BroderickCarlin/cgb-reg/README.md

# cgb-reg
CGB-REG chip replacement for Gameboy Color LCD drive circuitry
