BroderickCarlin/cgb-reg/cgb-reg/CGB-REG.kicad_pcb

## KiCad design cgb-reg/CGB-REG.kicad_pcb (2023-11-17)

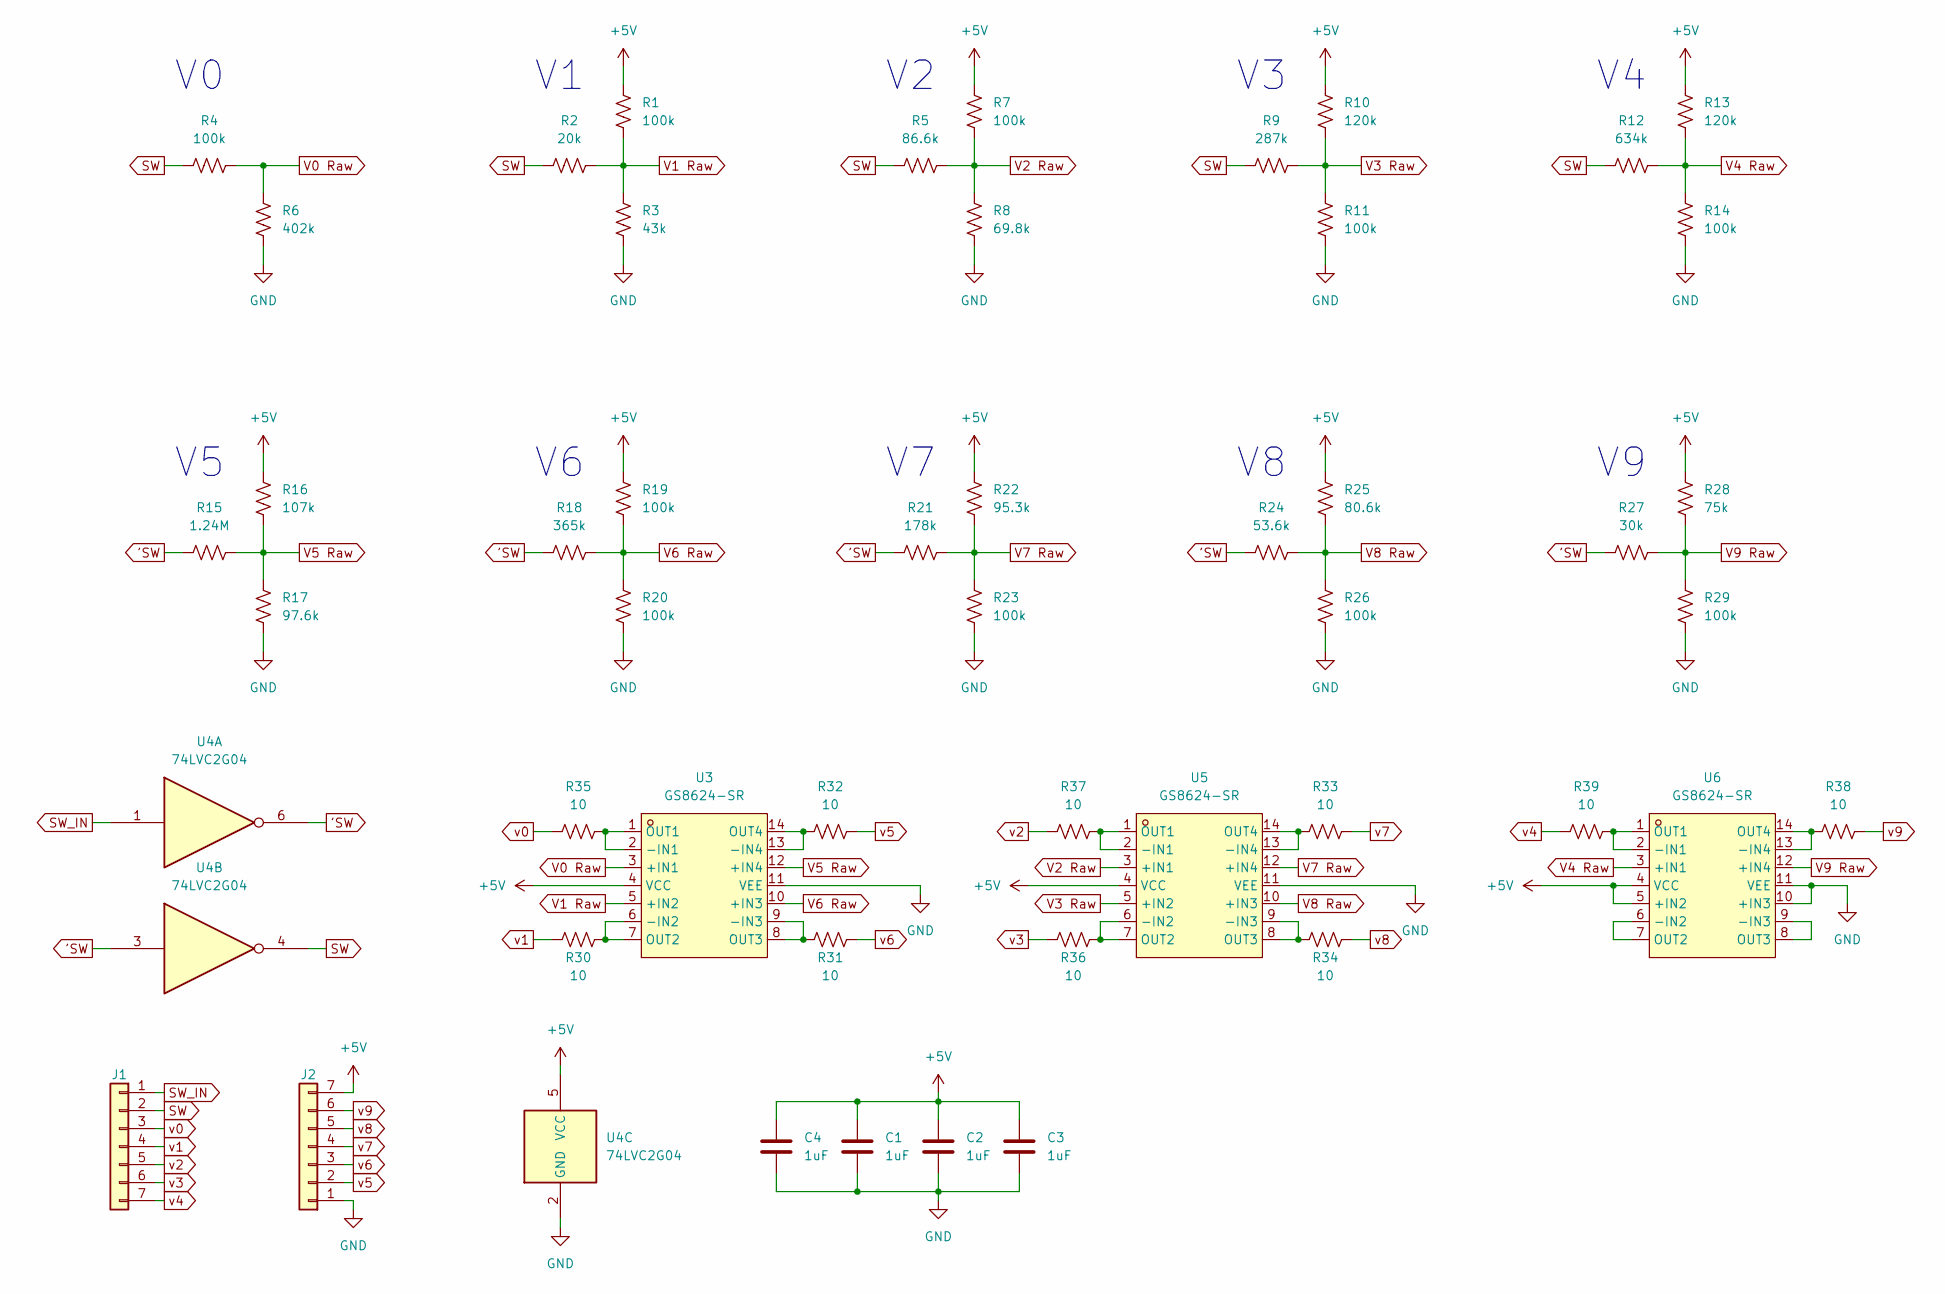
[picture p1: schematic CGB-REG.kicad_sch, CGB-REG Replacement Circuit]

Parts:
C1, C2, C3, C4: 1uF; C_0603_1608Metric; LCSC C89376
J1, J2: Conn_01x07; PinHeader_1x07_P2.54mm_Vertical
R1, R4, R7, R11, R14, R19, R20, R23, R26, R29: 100k; R_0603_1608Metric; LCSC C414506
R2: 20k; R_0603_1608Metric; LCSC C844340
R3: 43k; R_0603_1608Metric; LCSC C340523
R5: 86.6k; R_0603_1608Metric; LCSC C403381
R6: 402k; R_0603_1608Metric; LCSC C23048
R8: 69.8k; R_0603_1608Metric; LCSC C170663
R9: 287k; R_0603_1608Metric; LCSC C13174
R10, R13: 120k; R_0603_1608Metric; LCSC C325641
R12: 634k; R_0603_1608Metric; LCSC C321970
R15: 1.24M; R_0603_1608Metric; LCSC C367719
R16: 107k; R_0603_1608Metric; LCSC C103221
R17: 97.6k; R_0603_1608Metric; LCSC C507495
R18: 365k; R_0603_1608Metric; LCSC C367800
R21: 178k; R_0603_1608Metric; LCSC C103349
R22: 95.3k; R_0603_1608Metric; LCSC C912224
R24: 53.6k; R_0603_1608Metric; LCSC C103706
R25: 80.6k; R_0603_1608Metric; LCSC C2933260
R27: 30k; R_0603_1608Metric; LCSC C667692
R28: 75k; R_0603_1608Metric; LCSC C881187
R30, R31, R32, R33, R34, R35, R36, R37, R38, R39: 10; R_0603_1608Metric; LCSC C2791798
U3, U5, U6: GS8624-SR; SOIC-14_L8.6-W3.9-P1.27-LS6.0-BL; LCSC Part C605417
U4: 74LVC2G04; SOT-363_SC-70-6; LCSC C460538

Connections:
'SW: R15.2, R18.2, R21.2, R24.2, R27.2, U4.3, U4.6
+5V: C1.1, C2.1, C3.1, C4.1, J2.7, R1.1, R7.1, R10.1, R13.1, R16.1, R19.1, R22.1, R25.1, R28.1, U3.4 (VCC), U4.5 (VCC), U5.4 (VCC), U6.4 (VCC), U6.5 (+IN2)
GND: C1.2, C2.2, C3.2, C4.2, J2.1, R3.2, R6.2, R8.2, R11.2, R14.2, R17.2, R20.2, R23.2, R26.2, R29.2, U3.11 (VEE), U4.2 (GND), U5.11 (VEE), U6.10 (+IN3), U6.11 (VEE)
unnamed: R35.2, U3.1 (OUT1), U3.2 (-IN1)
unnamed: R30.2, U3.6 (-IN2), U3.7 (OUT2)
unnamed: R31.1, U3.8 (OUT3), U3.9 (-IN3)
unnamed: R32.1, U3.13 (-IN4), U3.14 (OUT4)
unnamed: R37.2, U5.1 (OUT1), U5.2 (-IN1)
unnamed: R36.2, U5.6 (-IN2), U5.7 (OUT2)
unnamed: R34.1, U5.8 (OUT3), U5.9 (-IN3)
unnamed: R33.1, U5.13 (-IN4), U5.14 (OUT4)
unnamed: R39.2, U6.1 (OUT1), U6.2 (-IN1)
unnamed: U6.6 (-IN2), U6.7 (OUT2)
unnamed: U6.8 (OUT3), U6.9 (-IN3)
unnamed: R38.2, U6.13 (-IN4), U6.14 (OUT4)
SW: J1.2, R2.2, R4.2, R5.2, R9.2, R12.2, U4.4
SW_IN: J1.1, U4.1
V0 Raw: R4.1, R6.1, U3.3 (+IN1)
V1 Raw: R1.2, R2.1, R3.1, U3.5 (+IN2)
V2 Raw: R5.1, R7.2, R8.1, U5.3 (+IN1)
V3 Raw: R9.1, R10.2, R11.1, U5.5 (+IN2)
V4 Raw: R12.1, R13.2, R14.1, U6.3 (+IN1)
V5 Raw: R15.1, R16.2, R17.1, U3.12 (+IN4)
V6 Raw: R18.1, R19.2, R20.1, U3.10 (+IN3)
V7 Raw: R21.1, R22.2, R23.1, U5.12 (+IN4)
V8 Raw: R24.1, R25.2, R26.1, U5.10 (+IN3)
V9 Raw: R27.1, R28.2, R29.1, U6.12 (+IN4)
v0: J1.3, R35.1
v1: J1.4, R30.1
v2: J1.5, R37.1
v3: J1.6, R36.1
v4: J1.7, R39.1
v5: J2.2, R32.2
v6: J2.3, R31.2
v7: J2.4, R33.2
v8: J2.5, R34.2
v9: J2.6, R38.1

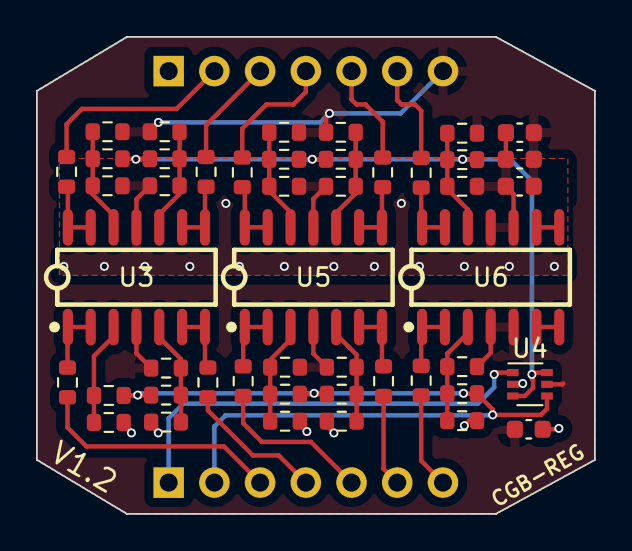
[picture p2: board CGB-REG.kicad_pcb from above]

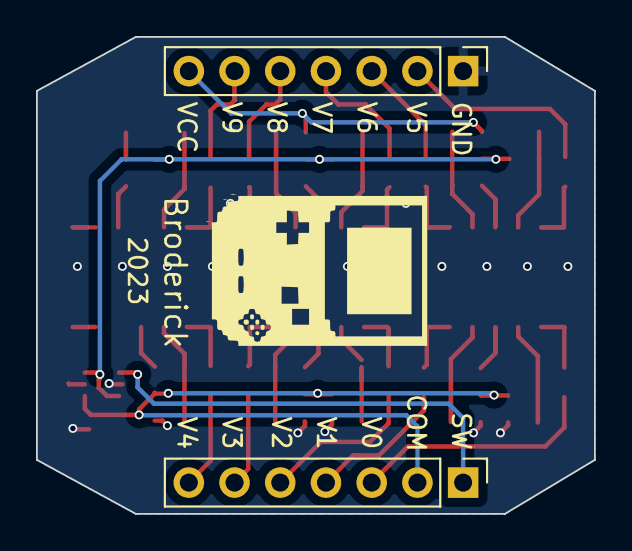
[picture p3: board CGB-REG.kicad_pcb from below]

Board: 2 copper layers, 31.0 x 26.5 mm, 49 parts (2 on the bottom side), 37 nets.
