BroderickCarlin/cgb-reg/cgb-reg-breakout/cgb-reg-breakout.kicad_pcb

## KiCad design cgb-reg-breakout/cgb-reg-breakout.kicad_pcb (2023-11-14)

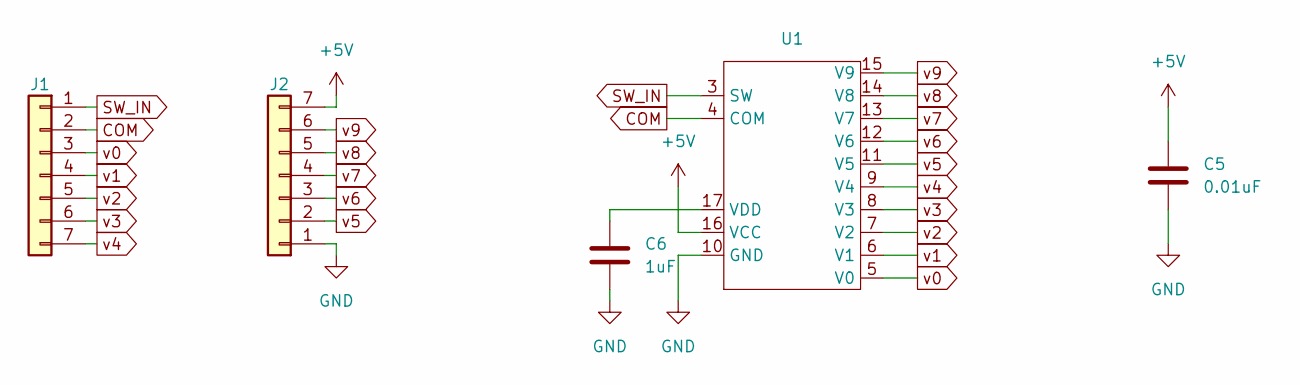
[picture p4: schematic cgb-reg-breakout.kicad_sch, CGB-REG Replacement Circuit]

Parts:
C5: 0.01uF; C_0603_1608Metric
C6: 1uF; C_0603_1608Metric; LCSC C89376
J1, J2: Conn_01x07; PinHeader_1x07_P2.54mm_Vertical
U1: CGB-REG

Connections:
+5V: C5.1, J2.7, U1.16 (VCC)
COM: J1.2, U1.4 (COM)
GND: C5.2, C6.2, J2.1, U1.10 (GND)
unnamed: C6.1, U1.17 (VDD)
SW_IN: J1.1, U1.3 (SW)
v0: J1.3, U1.5 (V0)
v1: J1.4, U1.6 (V1)
v2: J1.5, U1.7 (V2)
v3: J1.6, U1.8 (V3)
v4: J1.7, U1.9 (V4)
v5: J2.2, U1.11 (V5)
v6: J2.3, U1.12 (V6)
v7: J2.4, U1.13 (V7)
v8: J2.5, U1.14 (V8)
v9: J2.6, U1.15 (V9)

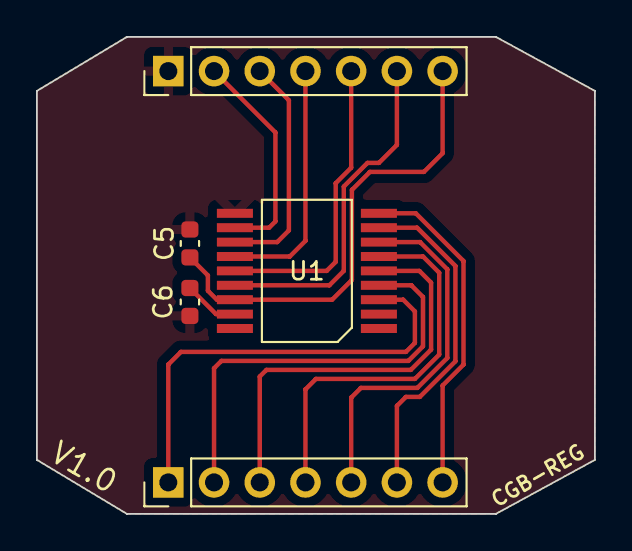
[picture p5: board cgb-reg-breakout.kicad_pcb from above]

Board: 2 copper layers, 31.0 x 26.5 mm, 5 parts (0 on the bottom side), 15 nets.
