BroderickCarlin/cgb-reg/pwr-dist/pwr-dist.kicad_pcb

## KiCad design pwr-dist/pwr-dist.kicad_pcb (2023-11-14)

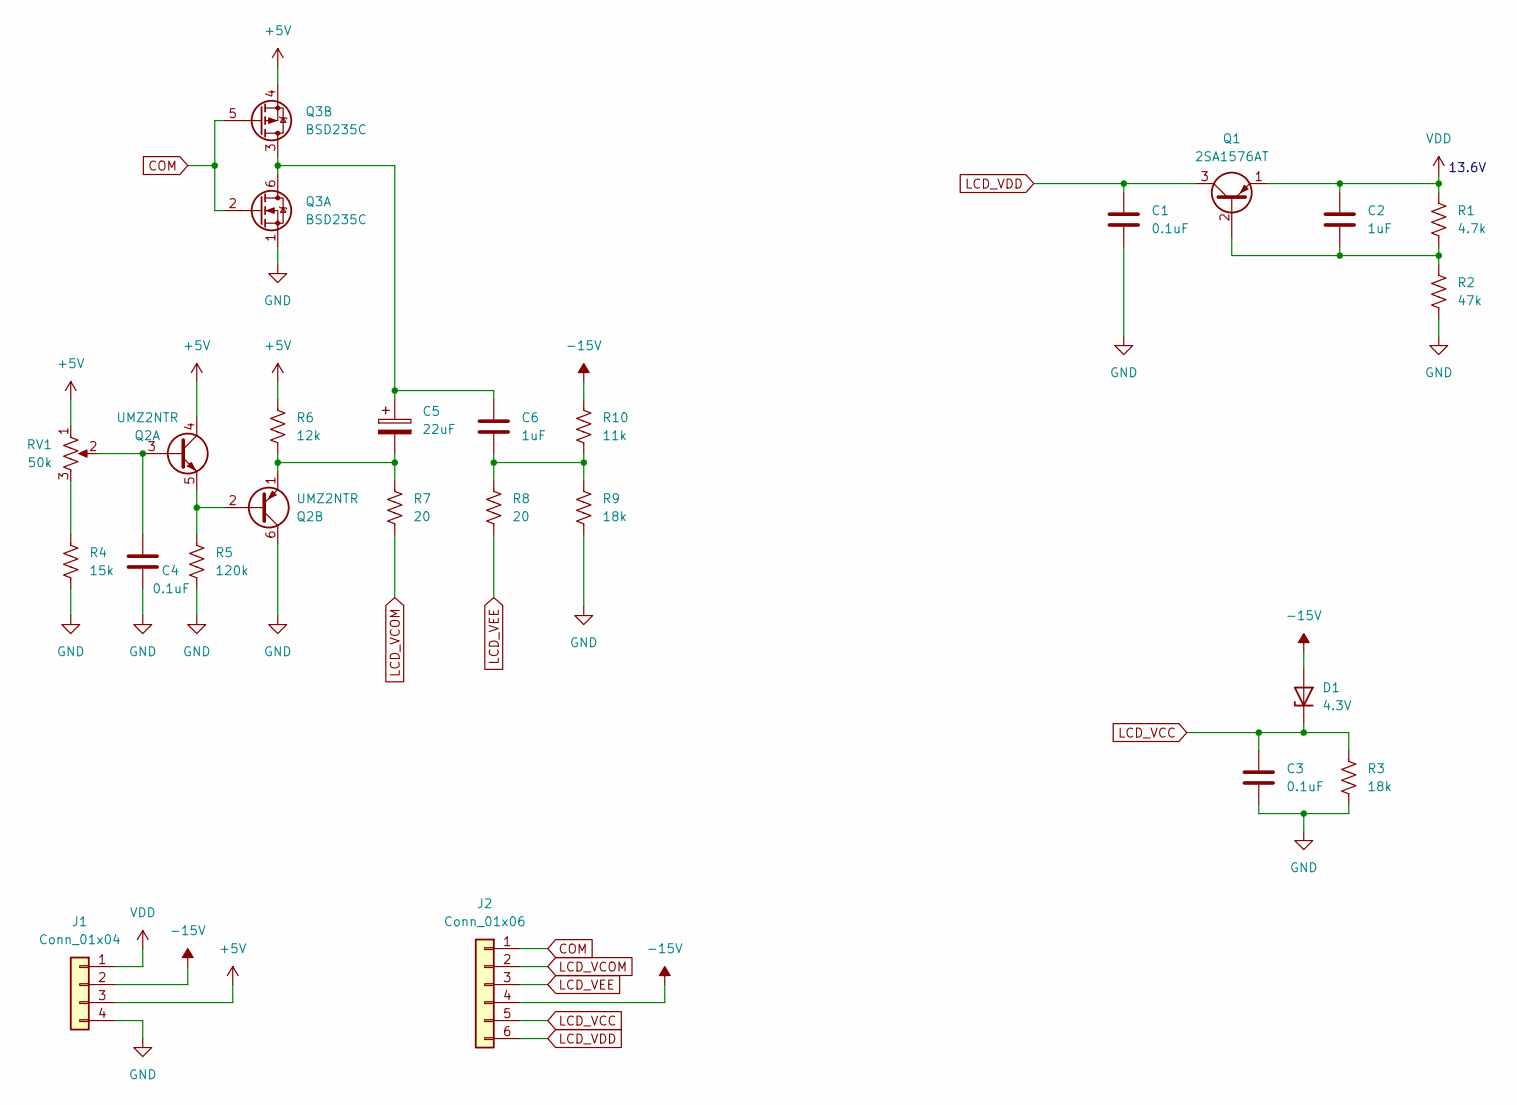
[picture p6: schematic pwr-dist.kicad_sch]

Parts:
C1, C3, C4: 0.1uF; R_0805_2012Metric_Pad1.20x1.40mm_HandSolder
C2, C6: 1uF; R_0805_2012Metric_Pad1.20x1.40mm_HandSolder
C5: 22uF; CP_Elec_4x5.3
D1: 4.3V; D_SOD-123
J1: Conn_01x04; PinHeader_1x04_P2.54mm_Vertical
J2: Conn_01x06; PinHeader_1x06_P2.54mm_Vertical
Q1: 2SA1576AT; SOT-323_SC-70_Handsoldering
Q2: UMZ2NTR; SOT-363_SC-70-6
Q3: BSD235C; SOT-666
R1: 4.7k; R_0805_2012Metric_Pad1.20x1.40mm_HandSolder
R2: 47k; R_0805_2012Metric_Pad1.20x1.40mm_HandSolder
R3, R9: 18k; R_0805_2012Metric_Pad1.20x1.40mm_HandSolder
R4: 15k; R_0805_2012Metric_Pad1.20x1.40mm_HandSolder
R5: 120k; R_0805_2012Metric_Pad1.20x1.40mm_HandSolder
R6: 12k; R_0805_2012Metric_Pad1.20x1.40mm_HandSolder
R7, R8: 20; R_0805_2012Metric_Pad1.20x1.40mm_HandSolder
R10: 11k; R_0805_2012Metric_Pad1.20x1.40mm_HandSolder
RV1: 50k; Potentiometer_Bourns_3314J_Vertical

Connections:
+5V: J1.3, Q2.4 (C1), Q3.4 (SP), R6.1, RV1.1
-15V: D1.2 (A), J1.2, J2.4, R10.1
COM: J2.1, Q3.2 (GN), Q3.5 (GP)
GND: C1.2, C3.2, C4.2, J1.4, Q2.6 (C2), Q3.1 (SN), R2.2, R3.2, R4.2, R5.2, R9.2
LCD_VCC: C3.1, D1.1 (K), J2.5, R3.1
LCD_VCOM: J2.2, R7.2
LCD_VDD: C1.1, J2.6, Q1.3 (C)
LCD_VEE: J2.3, R8.2
unnamed: C6.2, R8.1, R9.1, R10.2
unnamed: C2.2, Q1.2 (B), R1.2, R2.1
unnamed: C4.1, Q2.3 (B1), RV1.2
unnamed: Q2.2 (B2), Q2.5 (E1), R5.1
unnamed: C5.2, Q2.1 (E2), R6.2, R7.1
unnamed: C5.1, C6.1, Q3.3 (DP), Q3.6 (DN)
unnamed: R4.1, RV1.3
VDD: C2.1, J1.1, Q1.1 (E), R1.1

Notes on the sheet:
13.6V

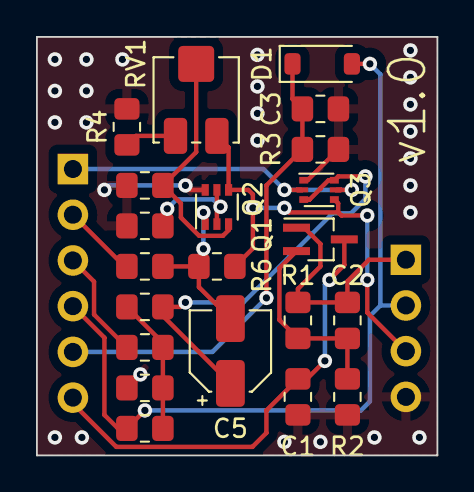
[picture p7: board pwr-dist.kicad_pcb from above]

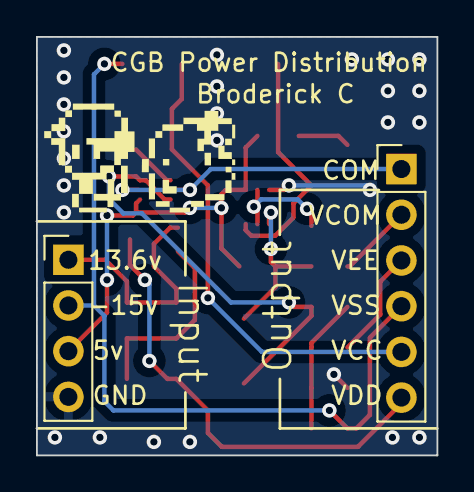
[picture p8: board pwr-dist.kicad_pcb from below]

Board: 2 copper layers, 22.2 x 23.2 mm, 23 parts (2 on the bottom side), 16 nets.
