BroderickCarlin/cgb-reg/(commit log)

2023-10-23 feat: Initial commit
    [CBG-REG.kicad_pcb, CBG-REG.kicad_sch]
2023-10-24 fix: Update resistor values to those in stock at JLCPCB
    [CBG-REG.kicad_pcb, CBG-REG.kicad_sch]
2023-10-24 feat: Add PCB silkscreen
    [CBG-REG.kicad_pcb]
2023-10-25 feat: Update accuracy of V5 signal
    [CBG-REG.kicad_sch]
2023-10-25 docs: Add pinout to the silkscreen
    [CBG-REG.kicad_pcb]
2023-10-25 feat: Switch connector to use castellations
    [CBG-REG.kicad_pcb]
2023-10-25 feat: Add Task file for generating gerbers
2023-10-25 fix(Task): Fix generating drill operation not using proper output dir
2023-10-30 feat: Bump schematic version to v1.1
    [CBG-REG.kicad_pcb]
2023-11-02 feat: Redesign the board to use an IC that JLCPCB has in stock
    [CBG-REG.kicad_pcb, CBG-REG.kicad_sch]
2023-11-13 feat: Add v1.0 of power distribution board
    also slight reorg of repo
    [CBG-REG.kicad_pcb, CBG-REG.kicad_sch, pwr-dist.kicad_pcb, pwr-dist.kicad_sch]
2023-11-14 feat: Add a new breakout for the official CGB-REG IC
    [CGB-REG.kicad_pcb, CGB-REG.kicad_sch, cgb-reg-breakout.kicad_pcb, cgb-reg-breakout.kicad_sch, pwr-dist.kicad_pcb]
2023-11-17 fix: Fix wrong footprint for inverter IC
    [CGB-REG.kicad_pcb, CGB-REG.kicad_sch]
